OpenSmell/smell-monitor/docs/figures/data_flow.png

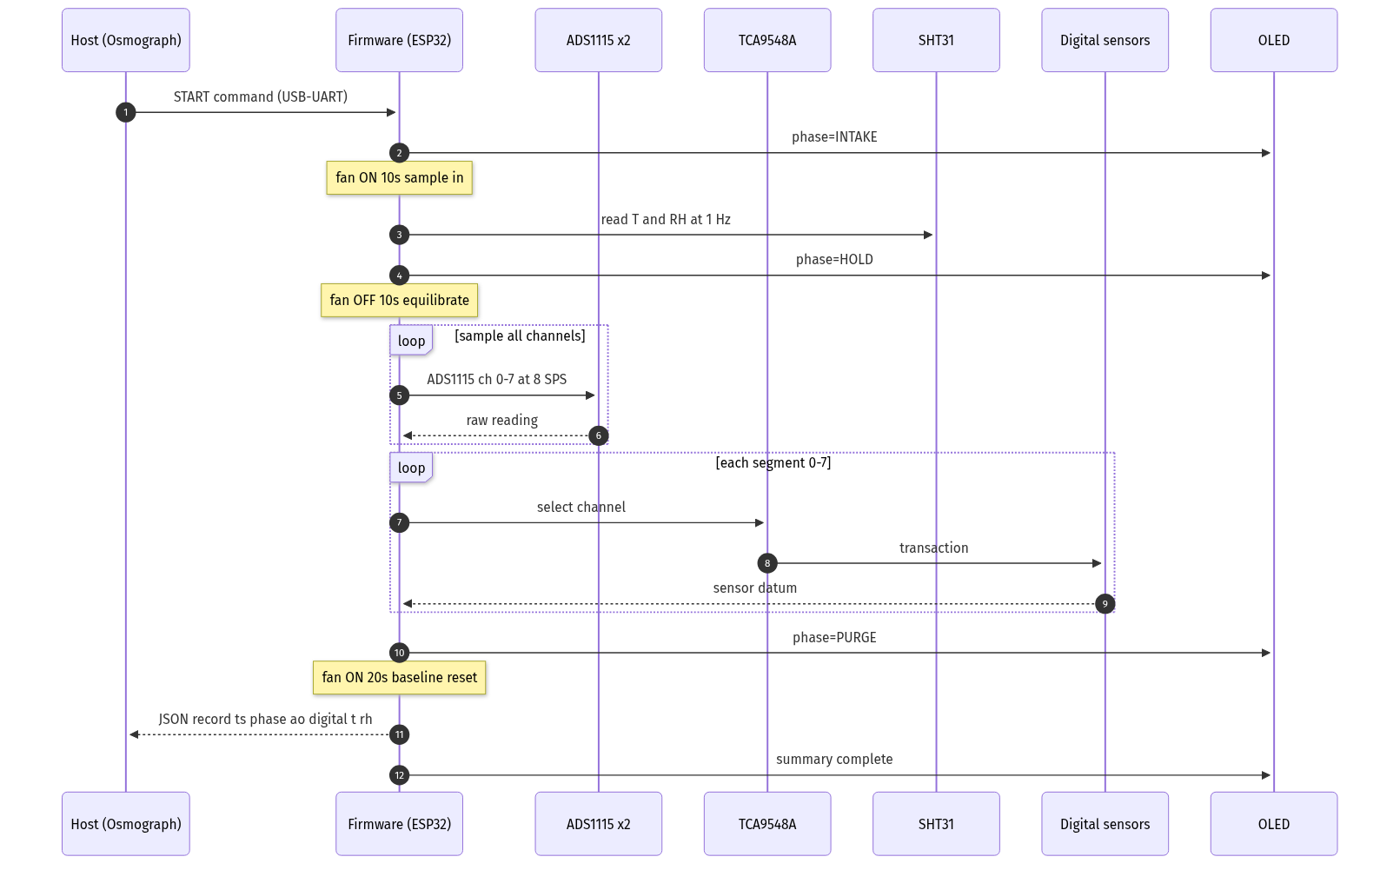
docs/figures/data_flow.png
