OpenSmell/smell-monitor/docs/figures/electrical_block.png

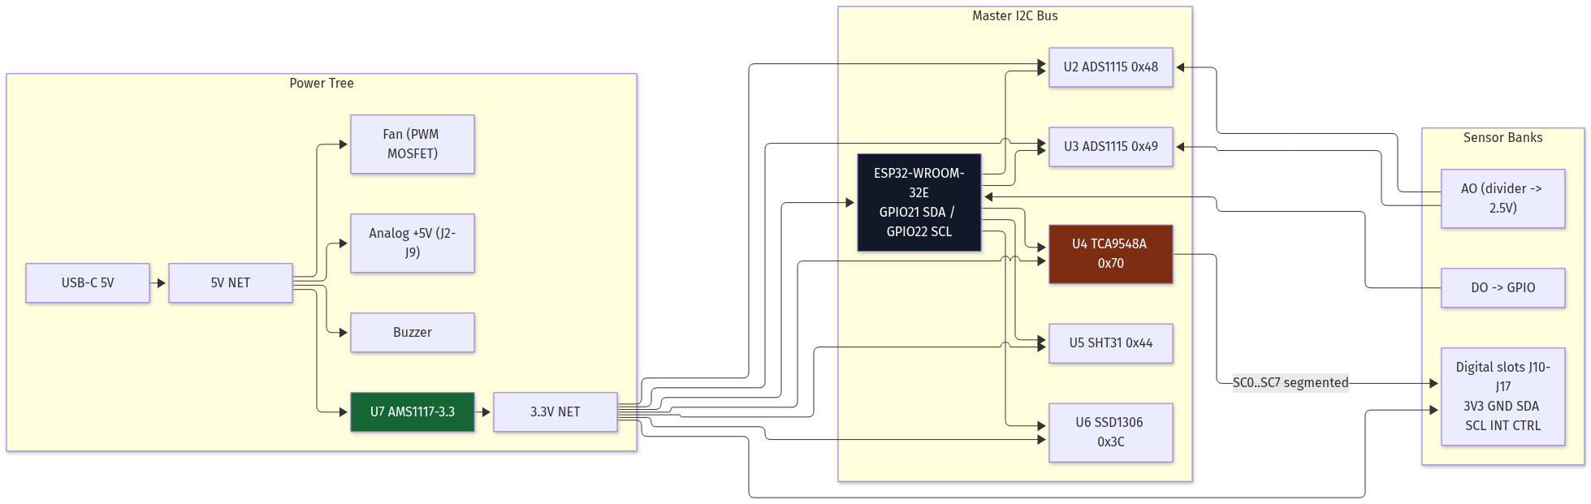
docs/figures/electrical_block.png
