OpenSmell/smell-monitor/docs/figures/mechanical_layout.png

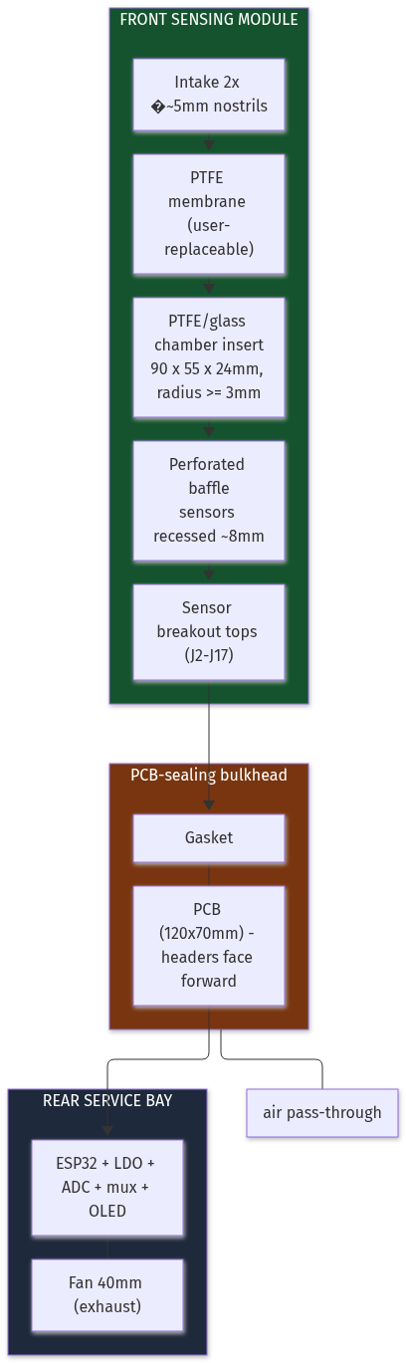
docs/figures/mechanical_layout.png
