OpenSmell/smell-monitor/docs/figures/sensor_slot_map.png

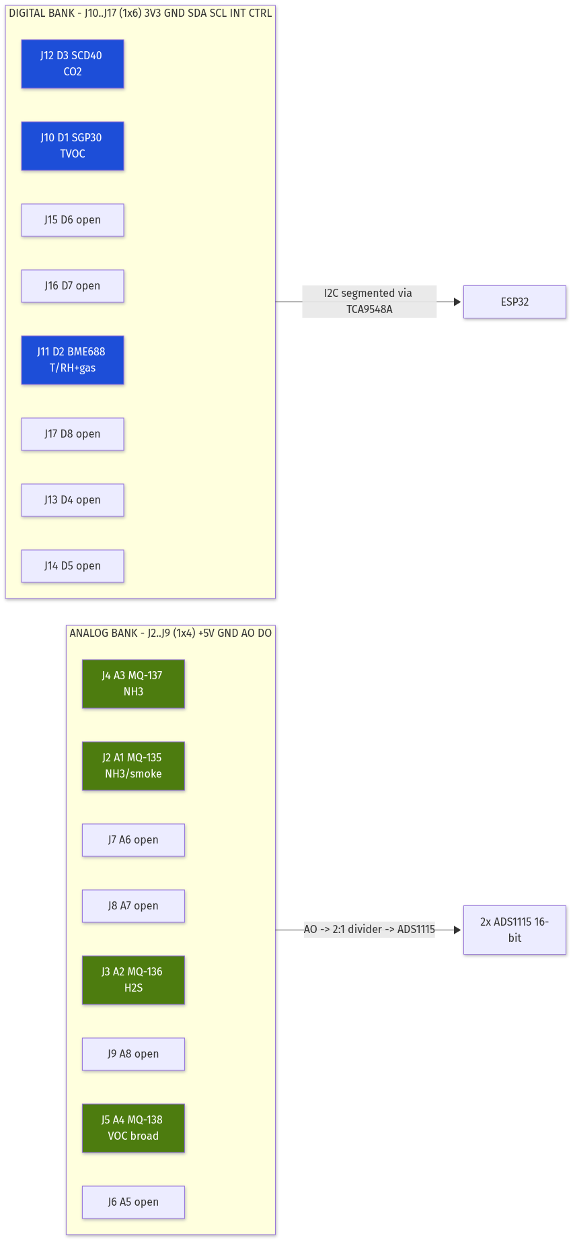
docs/figures/sensor_slot_map.png
