OpenSmell/smell-monitor/electrical/bom.csv

Designator | Value | Footprint | Quantity
BZ1 | MBT-12A05 | Buzzer_Beeper:Buzzer_12x9.5RM7.6 | 1
C1-C9 | 100nF | Capacitor_SMD:C_0603_1608Metric | 9
C10-C12 | 10uF | Capacitor_SMD:C_0603_1608Metric | 3
J1 | USB_C_16P | Connector_USB:USB_C_Receptacle_GCT_USB4105-xx-A_16P_TopMnt_Horizontal | 1
J2-J5 | 1x05 female | Connector_PinSocket_2.54mm:PinSocket_1x05_P2.54mm_Vertical | 4
J6-J9 | 1x06 female | Connector_PinSocket_2.54mm:PinSocket_1x06_P2.54mm_Vertical | 4
J10 | JST-PH 2P fan | Connector_JST:JST_PH_B2B-PH-K_1x02_P2.00mm_Vertical | 1
LED1 | Red | LED_SMD:LED_0603_1608Metric | 1
Q1 | AO3400A | Package_TO_SOT_SMD:SOT-23 | 1
Q2 | MMBT3904 | Package_TO_SOT_SMD:SOT-23 | 1
R1,R2 | 5.1k | Resistor_SMD:R_0603_1608Metric | 2
R3-R13,R17-R20 | 10k | Resistor_SMD:R_0603_1608Metric | 15
R14 | 330 | Resistor_SMD:R_0603_1608Metric | 1
R15,R16,R21-R28 | 4.7k | Resistor_SMD:R_0603_1608Metric | 10
SW1 | MEASURE | Button_Switch_SMD:SW_SPST_TL3342 | 1
SW2 | BOOT | Button_Switch_SMD:SW_SPST_TL3342 | 1
SW3 | RESET | Button_Switch_SMD:SW_SPST_TL3342 | 1
U1 | ESP32-WROOM-32E | RF_Module:ESP32-WROOM-32E | 1
U2 | ADS1115 | Package_SO:MSOP-10_3x3mm_P0.5mm | 1
U3 | CH340C | Package_SO:SOIC-16_3.9x9.9mm_P1.27mm | 1
U4 | TCA9548A | Package_SO:TSSOP-24_4.4x7.8mm_P0.65mm | 1
U5 | SHT31-DIS-B | Sensor_Humidity:Sensirion_DFN-8-1EP_2.5x2.5mm_P0.5mm_EP1.1x1.7mm | 1
U6 | SSD1306-B | Connector_PinHeader_2.54mm:PinHeader_1x04_P2.54mm_Vertical | 1
U7 | AMS1117-3.3 | Package_TO_SOT_SMD:SOT-223-3_TabPin2 | 1
