OpenSmell/smell-monitor/electrical/smell_monitor_v1_1/fab/smell_monitor_v1_1.step

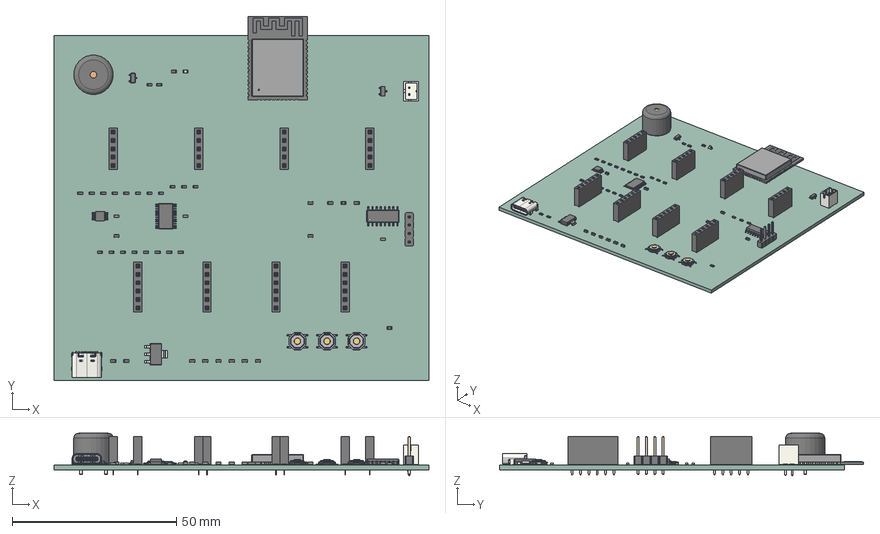
[picture p5: CAD file, 2026-10-21]
electrical/smell_monitor_v1_1/fab/smell_monitor_v1_1.step
114.0 x 110.8 x 12.9 mm
R_0603_1608Metric x 28
C_0603_1608Metric x 12
PinSocket_1x05_P2.54mm_Vertical x 4
TSSOP-24_4.4x7.8mm_P0.65mm
PinSocket_1x06_P2.54mm_Vertical x 4
SOT-23 x 2
SW_SPST_TL3342 x 3
PinHeader_1x04_P254mm_Vertical
Buzzer_12x95RM76
LED_0603_1608Metric
SOT-223
JST_B2B_PH_K
USB_C_Receptacle_16P_TopMnt_Horizontal_GCT_USB4105-xx-A
SOIC-16_3.9x9.9mm_P1.27mm
ESP32-WROOM-32E
MSOP-10_3x3mm_P0.5mm
smell_monitor_v1_1_PCB
