OpenSmell/smell-monitor/mechanical/drawings/sheets/OS-002.dxf

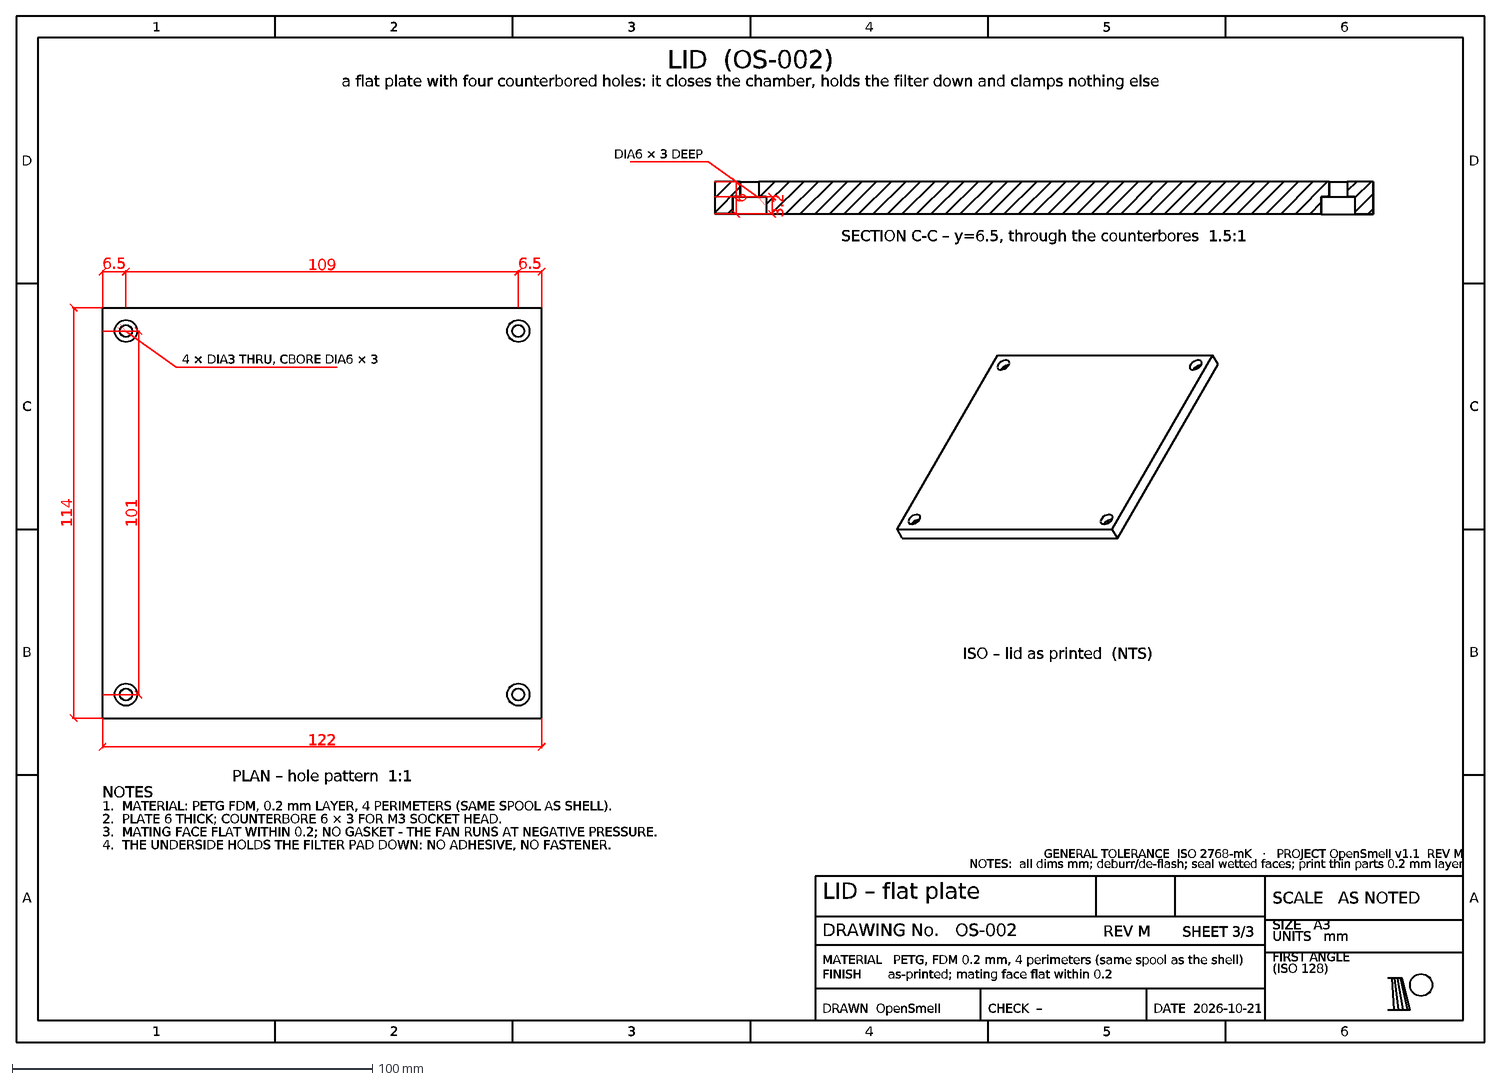
[picture p6: CAD file, 2026-10-21]
mechanical/drawings/sheets/OS-002.dxf
1
2
3
4
5
6
A
B
C
D
LID (OS-002)
a flat plate with four counterbored holes: it closes the chamber, holds the filter down and clamps nothing else
PLAN – hole pattern 1:1
122
114
6.5
109
101
4 × DIA3 THRU, CBORE DIA6 × 3
SECTION C-C – y=6.5, through the counterbores 1.5:1
3.2
DIA6 × 3 DEEP
ISO – lid as printed (NTS)
NOTES
1. MATERIAL: PETG FDM, 0.2 mm LAYER, 4 PERIMETERS (SAME SPOOL AS SHELL).
2. PLATE 6 THICK; COUNTERBORE 6 × 3 FOR M3 SOCKET HEAD.
3. MATING FACE FLAT WITHIN 0.2; NO GASKET - THE FAN RUNS AT NEGATIVE PRESSURE.
4. THE UNDERSIDE HOLDS THE FILTER PAD DOWN: NO ADHESIVE, NO FASTENER.
LID – flat plate
DRAWING No. OS-002
REV M
SHEET 3/3
MATERIAL PETG, FDM 0.2 mm, 4 perimeters (same spool as the shell)
FINISH as-printed; mating face flat within 0.2
DRAWN OpenSmell
CHECK –
DATE 2026-10-21
SCALE AS NOTED
SIZE A3
UNITS mm
FIRST ANGLE
(ISO 128)
NOTES: all dims mm; deburr/de-flash; seal wetted faces; print thin parts 0.2 mm layer
GENERAL TOLERANCE ISO 2768-mK · PROJECT OpenSmell v1.1 REV M
