OpenSmell/smell-monitor/mechanical/freecad/smell_monitor.STEP

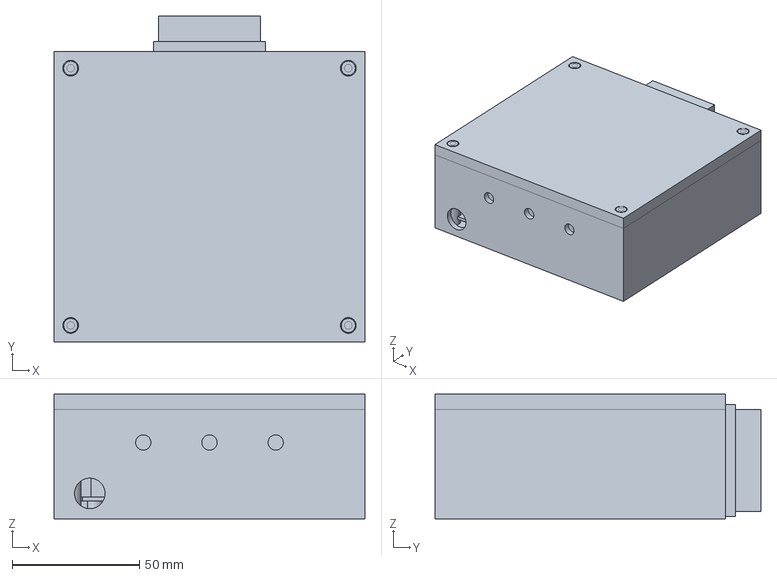
[picture p7: CAD file, 2026-10-21]
mechanical/freecad/smell_monitor.STEP
122.0 x 128.0 x 49.0 mm
