OpenSmell/smell-monitor/mechanical/drawings/sheets/OS-001.dxf

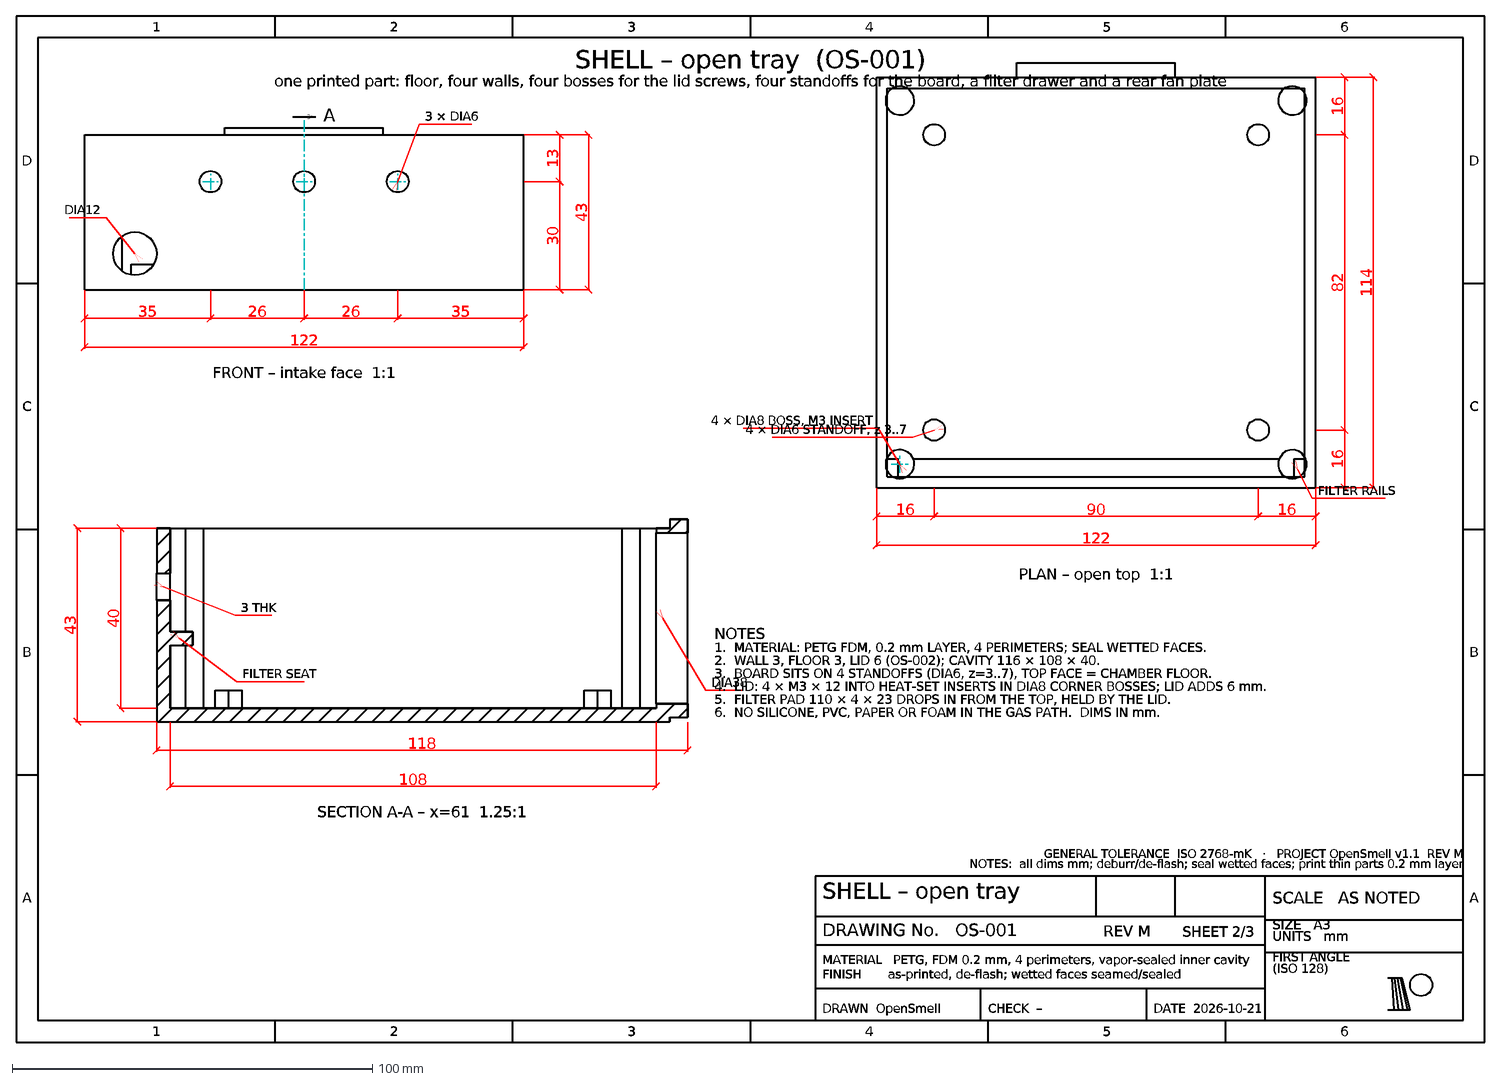
[picture p8: CAD file, 2026-10-21]
mechanical/drawings/sheets/OS-001.dxf
1
2
3
4
5
6
A
B
C
D
SHELL – open tray (OS-001)
one printed part: floor, four walls, four bosses for the lid screws, four standoffs for the board, a filter drawer and a rear fan plate
FRONT – intake face 1:1
35
26
122
30
13
43
3 × DIA6
DIA12
SECTION A-A – x=61 1.25:1
118
108
40
3 THK
FILTER SEAT
DIA38
PLAN – open top 1:1
16
90
82
114
4 × DIA8 BOSS, M3 INSERT
4 × DIA6 STANDOFF, z 3..7
FILTER RAILS
NOTES
1. MATERIAL: PETG FDM, 0.2 mm LAYER, 4 PERIMETERS; SEAL WETTED FACES.
2. WALL 3, FLOOR 3, LID 6 (OS-002); CAVITY 116 × 108 × 40.
3. BOARD SITS ON 4 STANDOFFS (DIA6, z=3..7), TOP FACE = CHAMBER FLOOR.
4. LID: 4 × M3 × 12 INTO HEAT-SET INSERTS IN DIA8 CORNER BOSSES; LID ADDS 6 mm.
5. FILTER PAD 110 × 4 × 23 DROPS IN FROM THE TOP, HELD BY THE LID.
6. NO SILICONE, PVC, PAPER OR FOAM IN THE GAS PATH. DIMS IN mm.
SHELL – open tray
DRAWING No. OS-001
REV M
SHEET 2/3
MATERIAL PETG, FDM 0.2 mm, 4 perimeters, vapor-sealed inner cavity
FINISH as-printed, de-flash; wetted faces seamed/sealed
DRAWN OpenSmell
CHECK –
DATE 2026-10-21
SCALE AS NOTED
SIZE A3
UNITS mm
FIRST ANGLE
(ISO 128)
NOTES: all dims mm; deburr/de-flash; seal wetted faces; print thin parts 0.2 mm layer
GENERAL TOLERANCE ISO 2768-mK · PROJECT OpenSmell v1.1 REV M
