OpenSmell/smell-monitor/mechanical/freecad/smell_monitor_lid.STEP

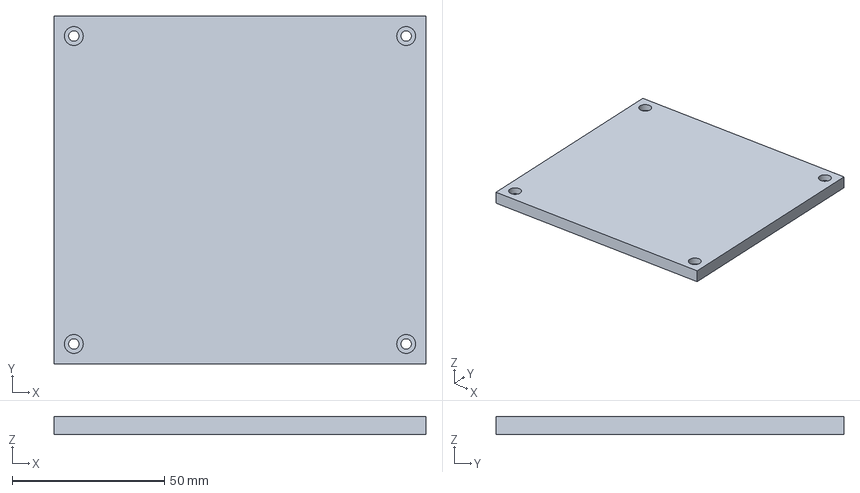
[picture p9: CAD file, 2026-10-21]
mechanical/freecad/smell_monitor_lid.STEP
122.0 x 114.0 x 6.00 mm
