OpenSmell/smell-monitor/mechanical/drawings/sheets/OS-000.dxf

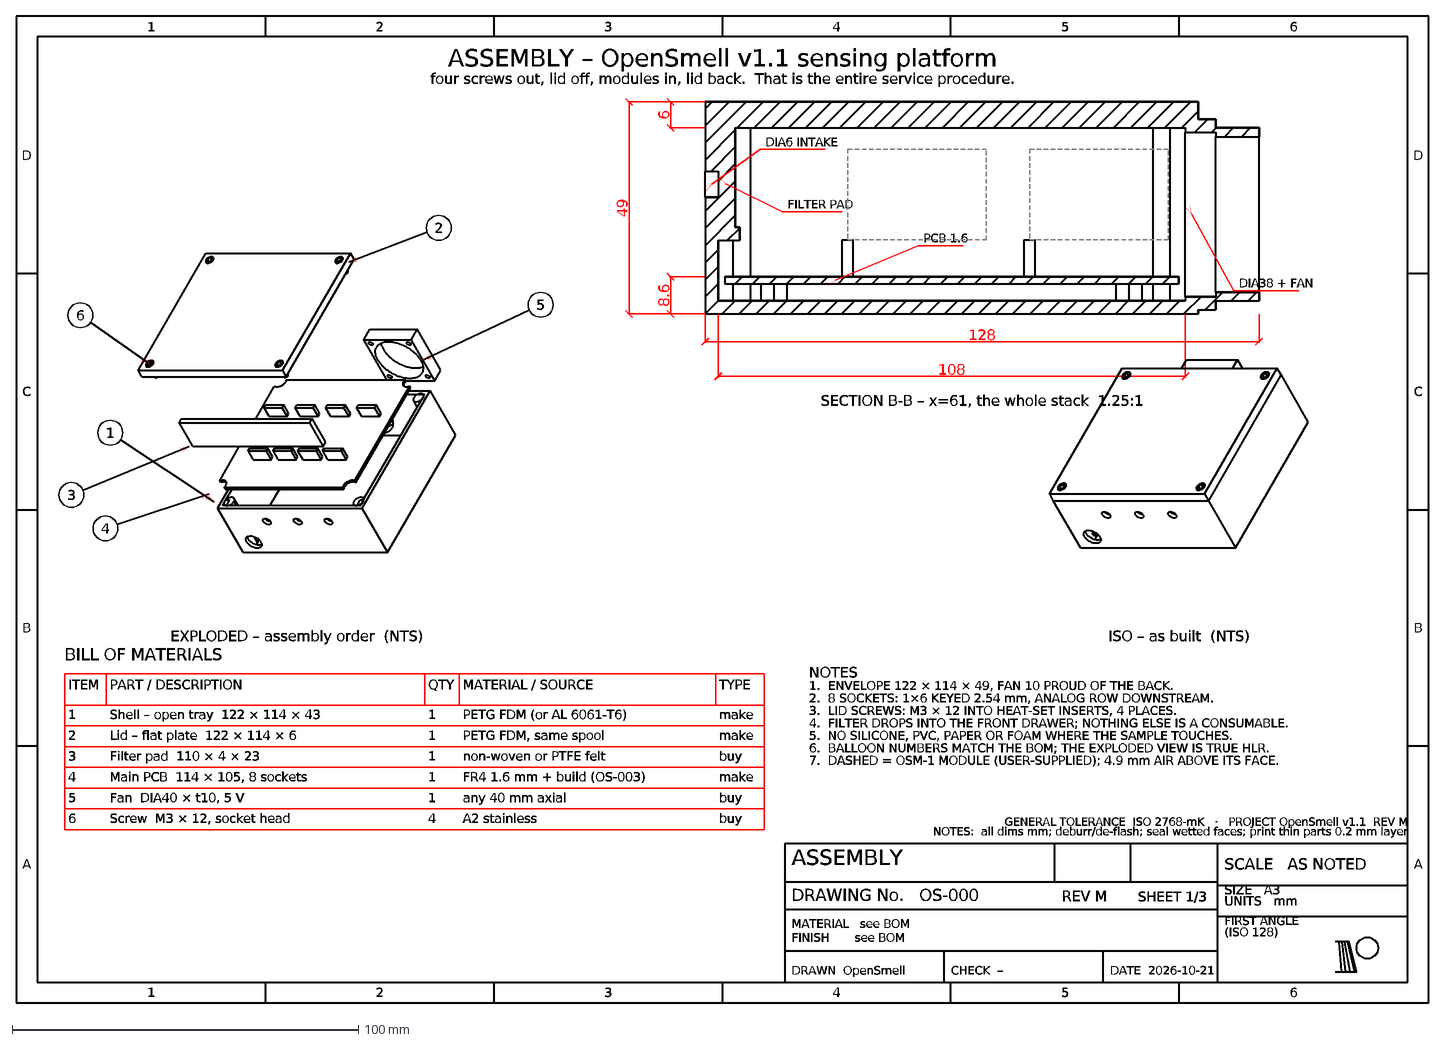
[picture p10: CAD file, 2026-10-21]
mechanical/drawings/sheets/OS-000.dxf
1
2
3
4
5
6
A
B
C
D
ASSEMBLY – OpenSmell v1.1 sensing platform
four screws out, lid off, modules in, lid back. That is the entire service procedure.
EXPLODED – assembly order (NTS)
SECTION B-B – x=61, the whole stack 1.25:1
128
108
8.6
49
DIA6 INTAKE
FILTER PAD
PCB 1.6
DIA38 + FAN
ISO – as built (NTS)
BILL OF MATERIALS
ITEM
PART / DESCRIPTION
QTY
MATERIAL / SOURCE
TYPE
Shell – open tray 122 × 114 × 43
PETG FDM (or AL 6061-T6)
make
Lid – flat plate 122 × 114 × 6
PETG FDM, same spool
Filter pad 110 × 4 × 23
non-woven or PTFE felt
buy
Main PCB 114 × 105, 8 sockets
FR4 1.6 mm + build (OS-003)
Fan DIA40 × t10, 5 V
any 40 mm axial
Screw M3 × 12, socket head
A2 stainless
NOTES
1. ENVELOPE 122 × 114 × 49, FAN 10 PROUD OF THE BACK.
2. 8 SOCKETS: 1×6 KEYED 2.54 mm, ANALOG ROW DOWNSTREAM.
3. LID SCREWS: M3 × 12 INTO HEAT-SET INSERTS, 4 PLACES.
4. FILTER DROPS INTO THE FRONT DRAWER; NOTHING ELSE IS A CONSUMABLE.
5. NO SILICONE, PVC, PAPER OR FOAM WHERE THE SAMPLE TOUCHES.
6. BALLOON NUMBERS MATCH THE BOM; THE EXPLODED VIEW IS TRUE HLR.
7. DASHED = OSM-1 MODULE (USER-SUPPLIED); 4.9 mm AIR ABOVE ITS FACE.
ASSEMBLY
DRAWING No. OS-000
REV M
SHEET 1/3
MATERIAL see BOM
FINISH see BOM
DRAWN OpenSmell
CHECK –
DATE 2026-10-21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
