OpenSmell/smell-monitor/mechanical/freecad/smell_monitor_shell.STEP

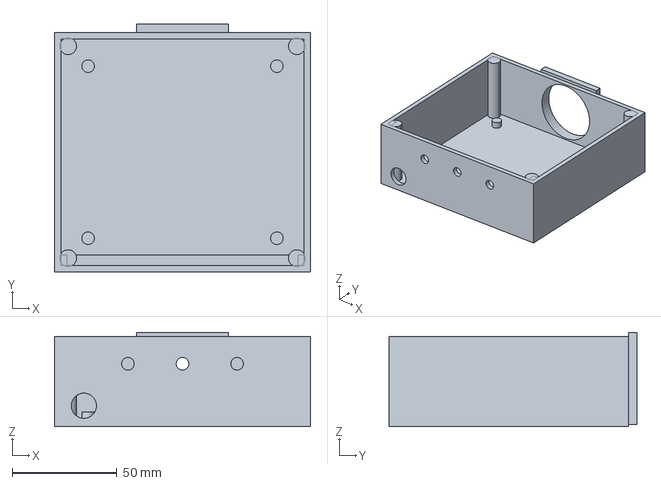
[picture p11: CAD file, 2026-10-21]
mechanical/freecad/smell_monitor_shell.STEP
122.0 x 118.0 x 45.0 mm
