OpenSmell/smell-monitor/mechanical/freecad/smell_monitor_baffle.STEP

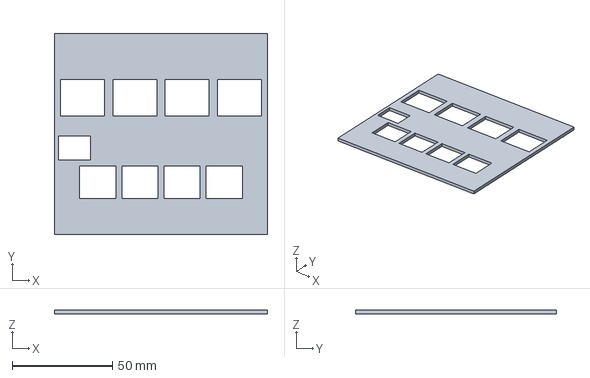
[picture p12: CAD file, 2026-10-20]
mechanical/freecad/smell_monitor_baffle.STEP
106.0 x 100.0 x 2.00 mm
