OpenSmell/smell-monitor/(list of files, cad)

Other CAD files:
mechanical/freecad/smell_monitor_baffle.stl
mechanical/freecad/smell_monitor_lid.stl
mechanical/freecad/smell_monitor_shell.stl
