OpenSmell/smell-monitor/electrical/smell_monitor_v1_1/smell_monitor_v1_1.pdf

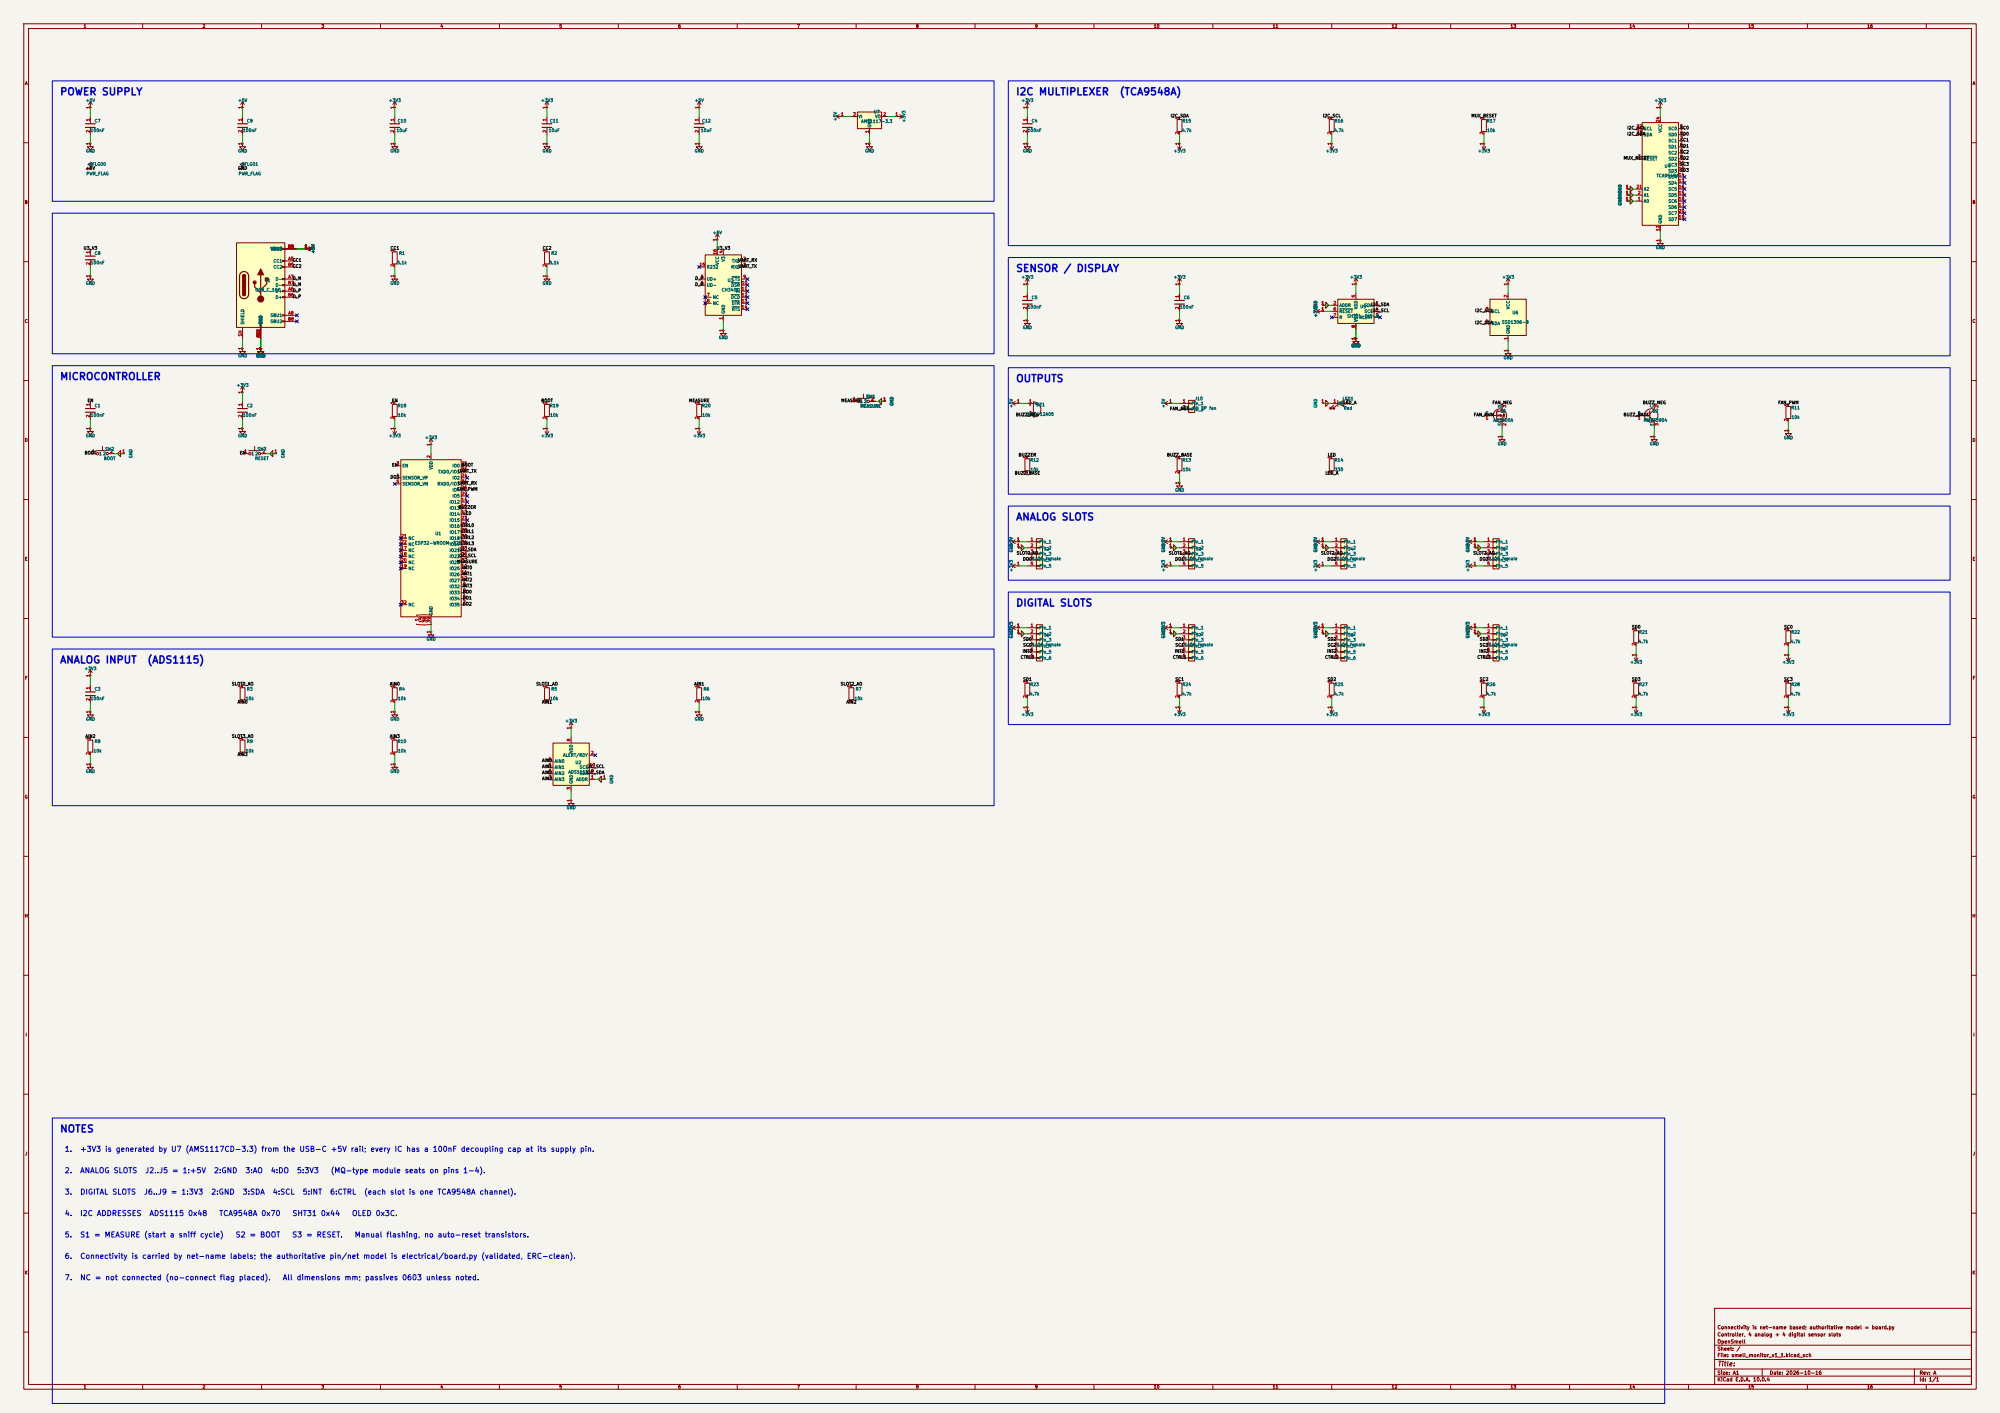
[picture p13: page 1]

4 UD+ 5 UD- 6 NC 7 NC 8 CTS 9 DSR 10 RI 11 DCD 12 DTR 13 RTS 14 R232 15 VCC 16 U3 CH340C

Connectivity is net-name based; authoritative model = board.py GND

1. +3V3 is generated by U7 (AMS1117CD-3.3) from the USB-C +5V rail; every IC has a 100nF decoupling cap at its supply pin.

3. DIGITAL SLOTS J6..J9 = 1:3V3 2:GND 3:SDA 4:SCL 5:INT 6:CTRL (each slot is one TCA9548A channel).

6. Connectivity is carried by net-name labels; the authoritative pin/net model is electrical/board.py (validated, ERC-clean).

Size: A1 | Rev: A
KiCad E.D.A. 10.0.4 | Id: 1/1
