OpenSmell/smell-monitor/mechanical/drawings/sheets/OpenSmell_v1.1_sheets.pdf

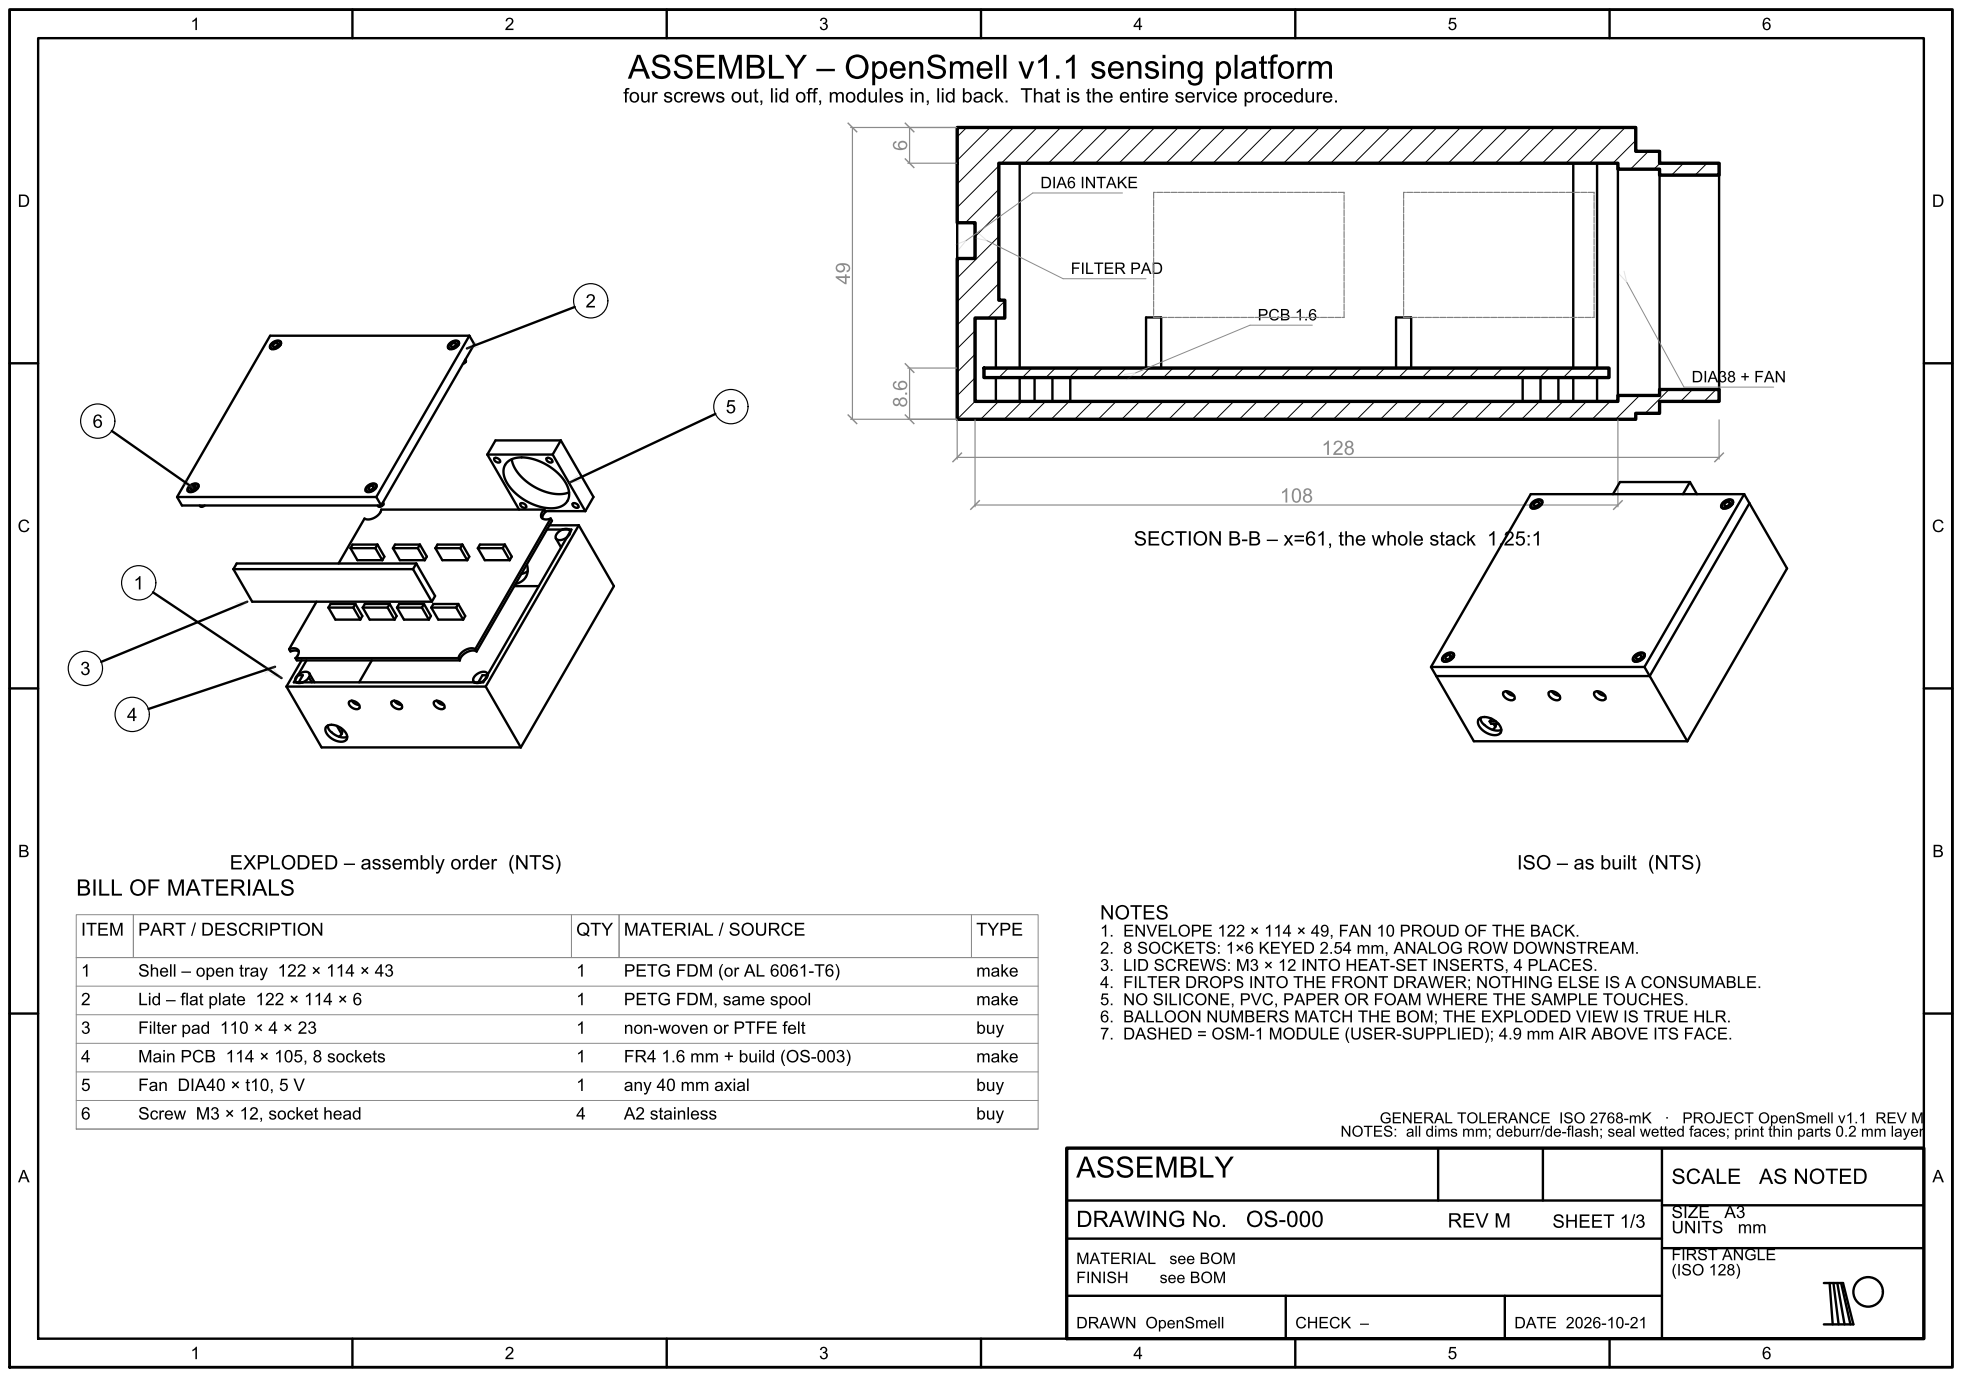
[picture p14: page 1]

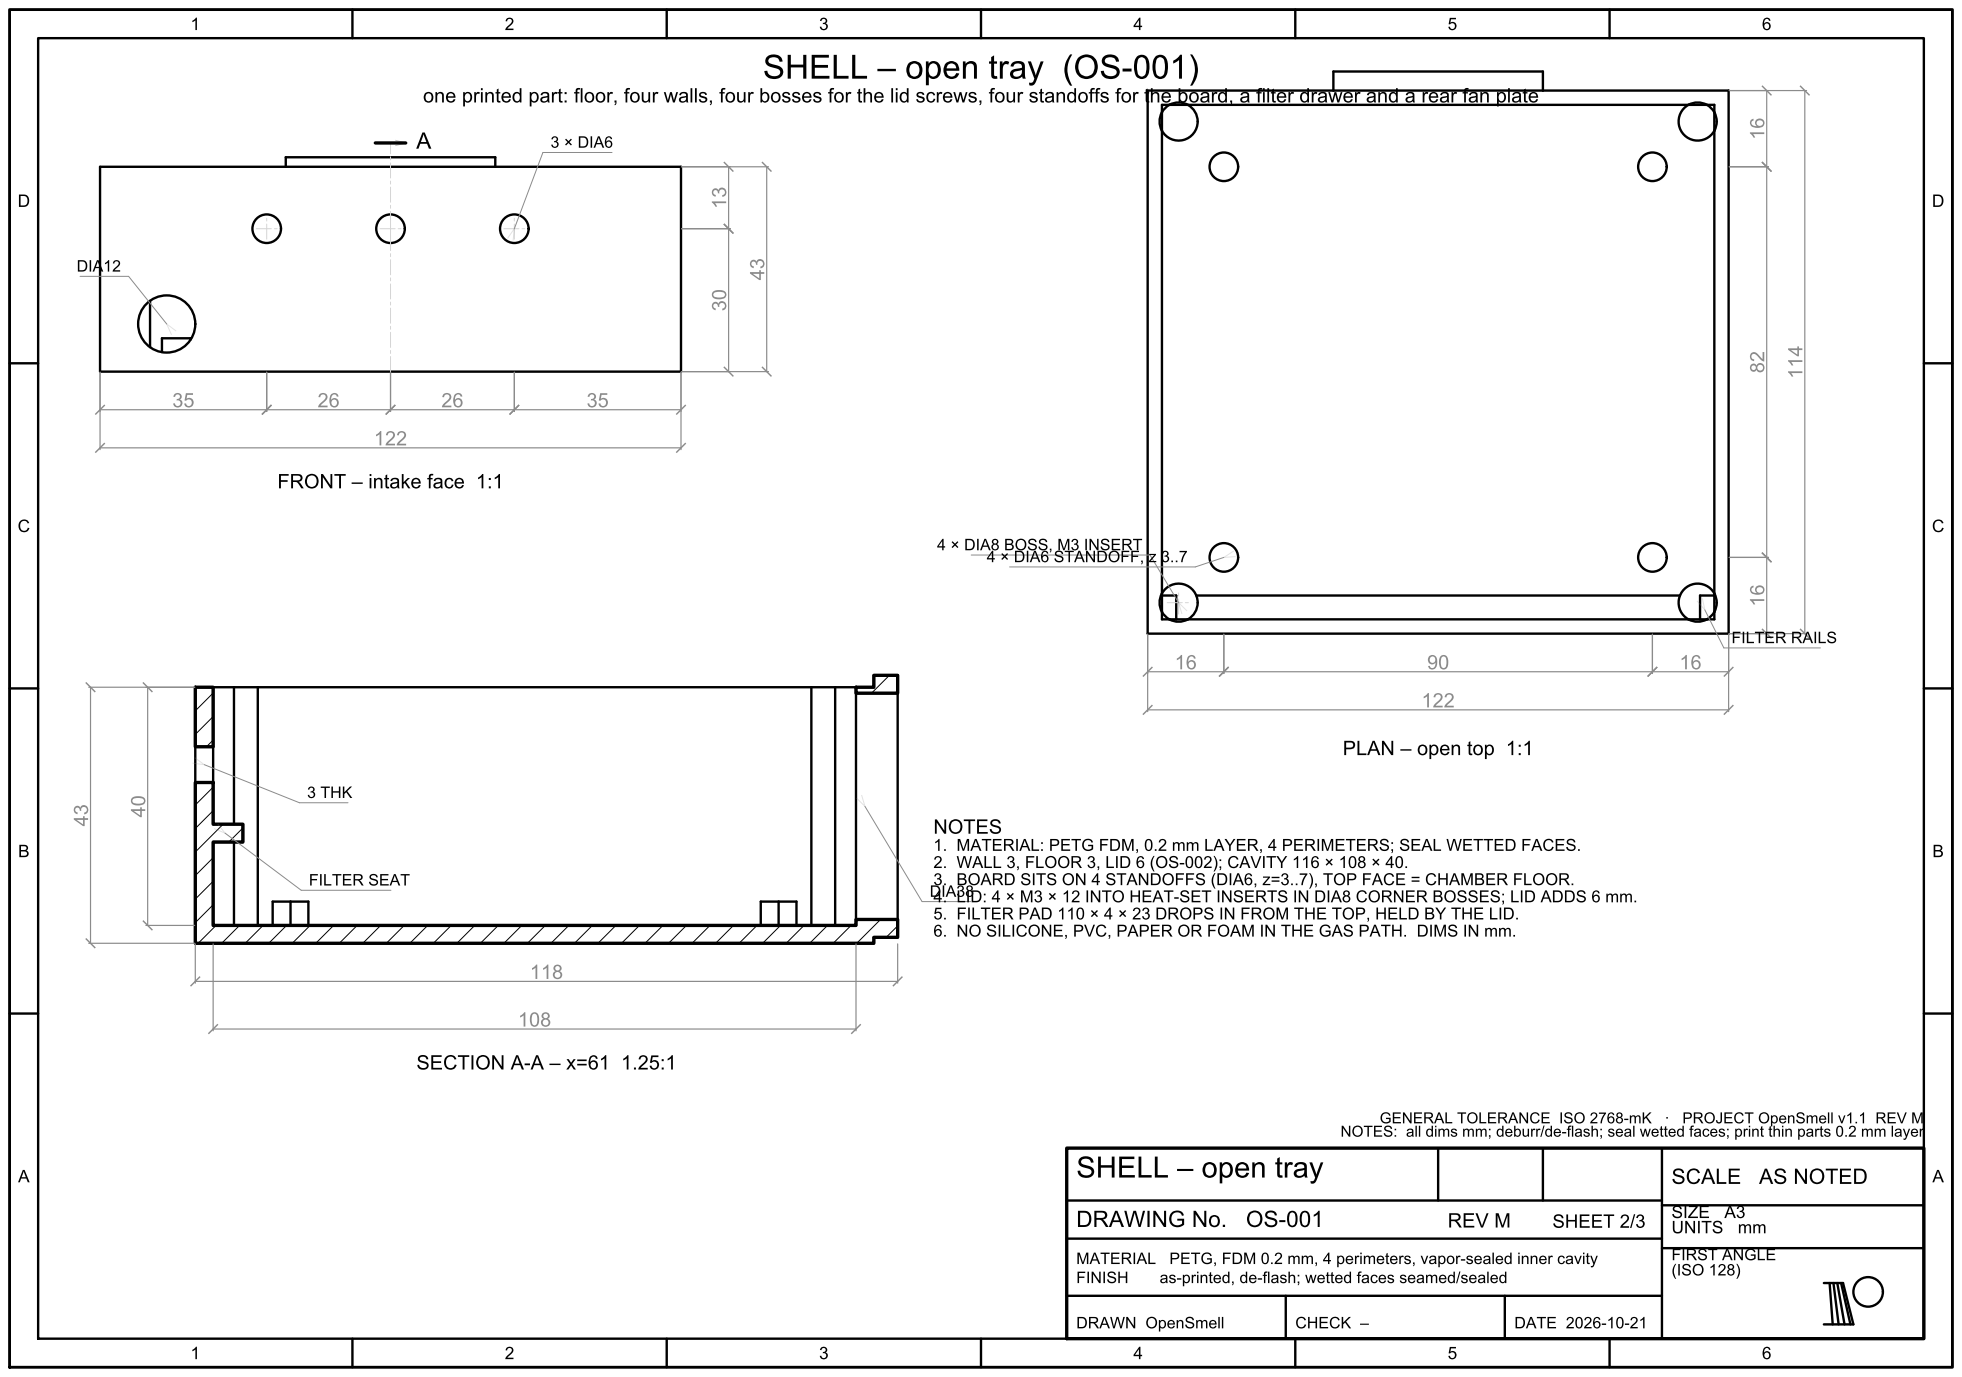
[picture p15: page 2]

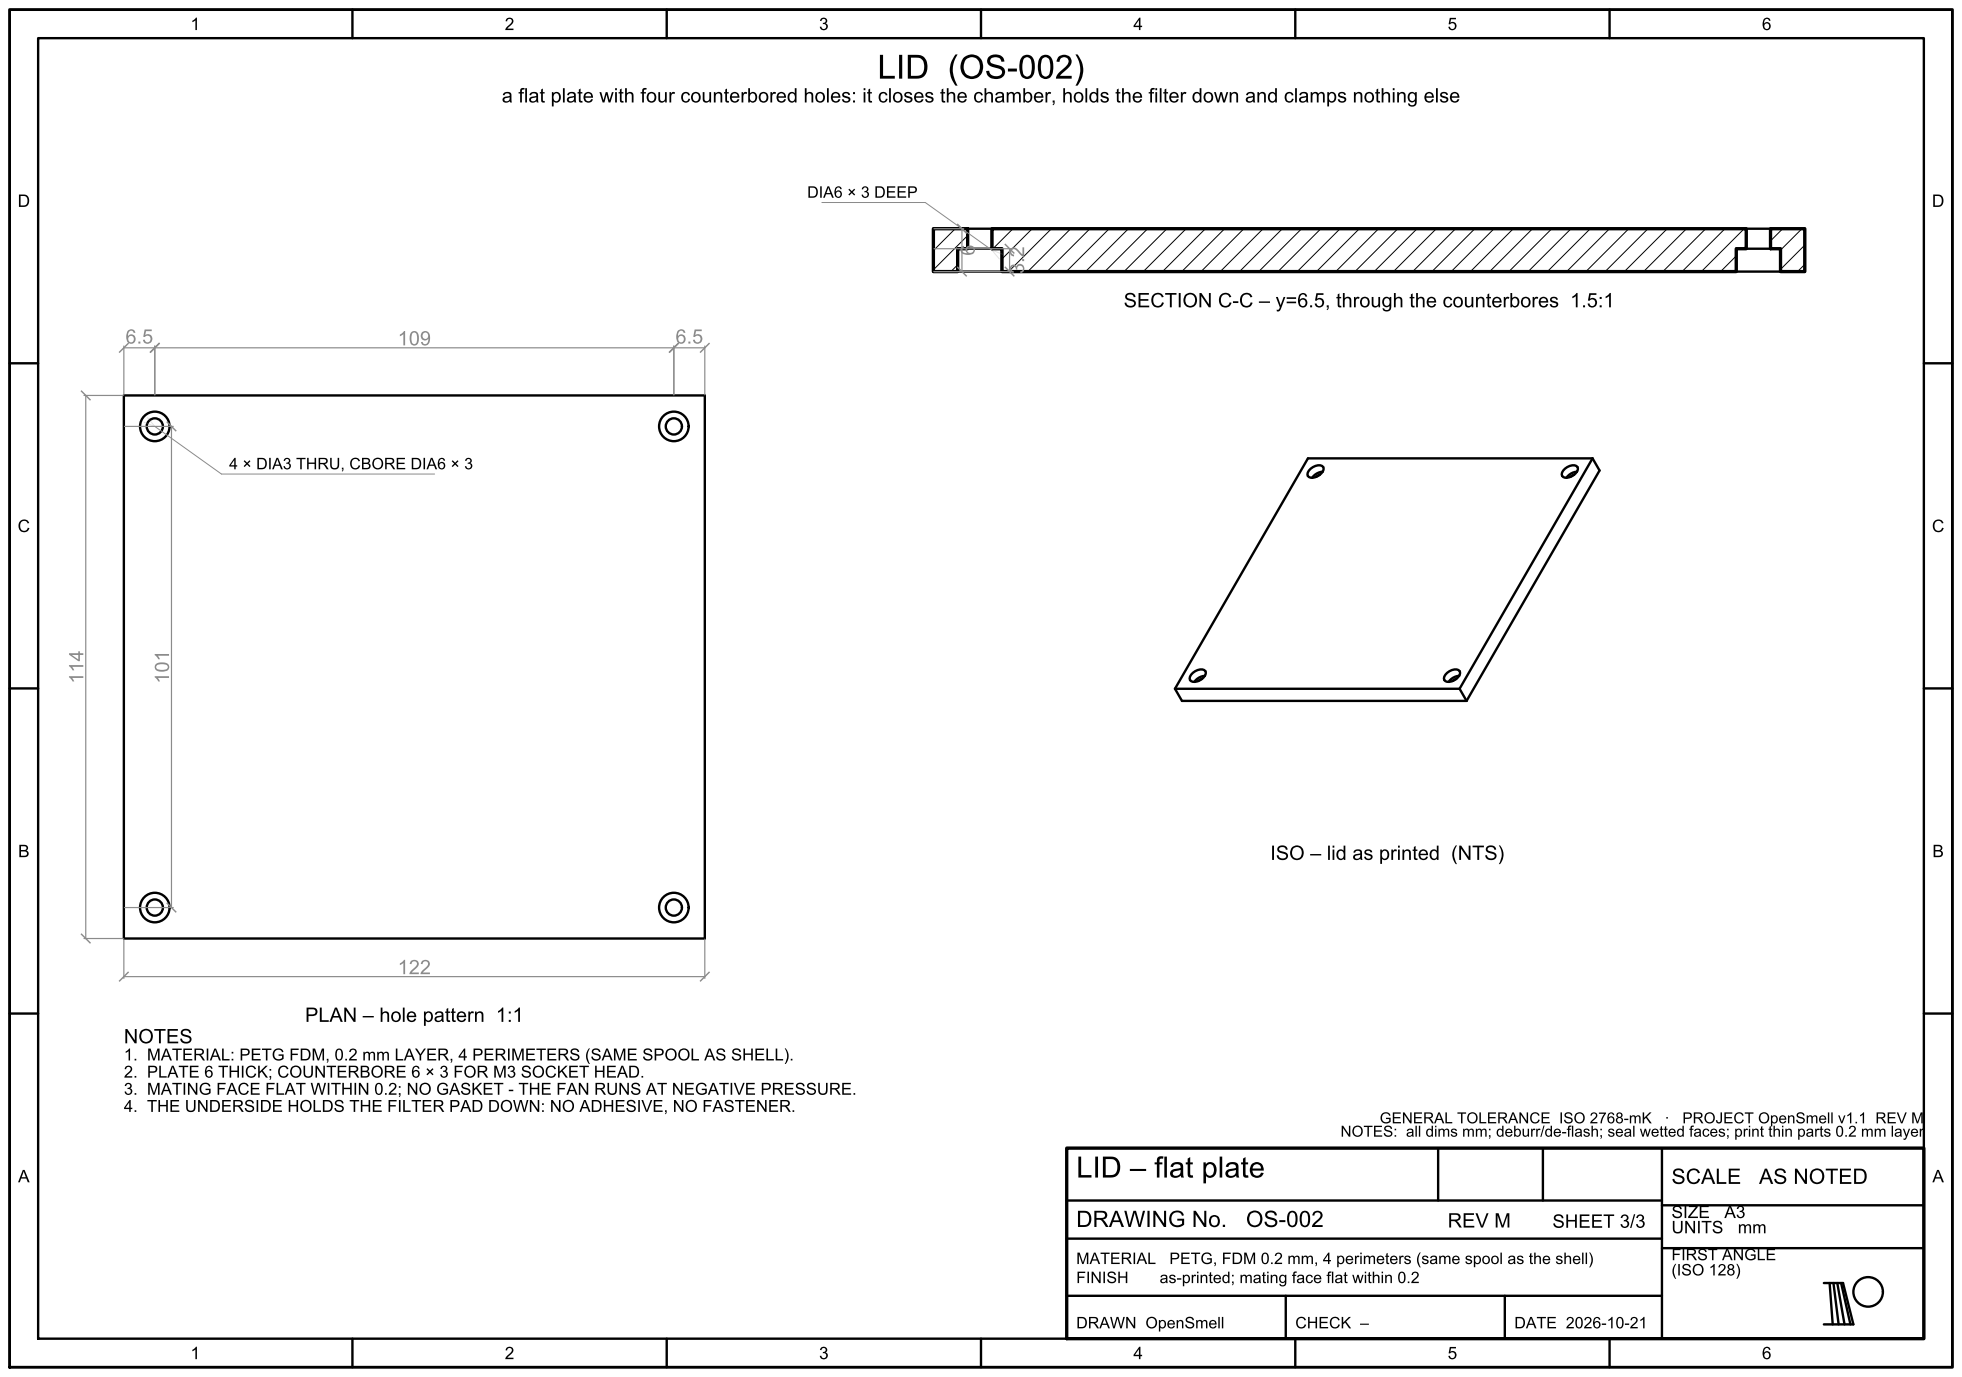
[picture p16: page 3]
