OpenSmell/smell-monitor/(commit log)

2026-09-25 Update README with project details and guidelines
    Added detailed project overview, hardware architecture, sensor interfaces, project status, and contributing guidelines.
2026-10-12 chore: initialize repository with KiCad v0 design and BOM
2026-10-13 docs: lock v1 architecture - spec, manual, assembly guide, diagrams
    - docs/architecture.md: authoritative v1 spec (pneumatic, sensing, electrical, mechanical)
    - docs/manual.md: user-facing printable manual
    - docs/assembly_guide.md: build + fabrication instructions
    - docs/figures/: 5 mermaid diagrams (.mmd + svg + png)
    - README: rewritten to match BOM/architecture; fixes old discrepancies
    - BOM: add U7 AMS1117-3.3 (missing 3.3V rail was a v0 gap)
    - Sub-folder READMEs for electrical/mechanical/firmware
2026-10-16 Add verification scripts for CAD and electrical interfaces
    - Introduced `style_smell_monitor.py` to enhance the visibility of the smell monitor model in FreeCAD.
    - Added `verify_cad.py` for numeric verification of CAD deliverables against the source of truth.
    - Created `verify_electrical.py` to validate the electrical interface and ensure pin budget compliance.
    - Implemented `verify_netlist.py` to check the parity between the KiCad-exported netlist and the board model.
    - Developed `verify_orthogonality.py` to analyze response-diversity and ensure invariants are met.
    - Added `verify_sensor_matrix.py` to validate sensor placement and ensure the recommended pack covers all personas.
2026-10-17 fix(mechanical): seat the PCB as the chamber floor, flip the flow order
    The stacking error: PCB_Z was CAV_Z1 - 1.6 = 58.4 mm, so the board sat in the
    cavity *ceiling* - through the 3 x D6 nostril bores (z 52..58) and the filter
    slab. Air could not enter. PCB_Z is now FLOOR - PCB_T with a matching 1.6 mm
    rebate cut in the shell floor, so the board's top face IS the cavity floor.
    That is the only datum where 4.6's own numbers close: 12 + 37 = 49 = BAFFLE_Z,
    12 + 29 = 41, 49 - 41 = 8 mm recess. PCB_Z is derived from FLOOR/PCB_T, not
    retyped, so the identity cannot drift again.
    - nostril axis 58 -> 55 mm: the full bore now opens into the 11 mm flow lane
    instead of being clipped by the cavity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
2026-10-17 feat(electrical): generate, route and gate the v1.1 PCB
    The routed board in git was not reproducible from anything committed. It is now
    produced by a pipeline in which every stage refuses to do the dangerous thing:
    - gen_pcb.py placement only (outline, footprints, netclasses); refuses to
    overwrite a board that already carries copper without --force.
    The 8 sensing headers land exactly on interface.ANALOG_HEADERS /
    DIGITAL_HEADERS, i.e. exactly on the chamber wells.
    - route_pcb.py DSN -> FreeRouting (java -jar, -mp 12) -> SES; refuses to save
    unless 0 unconnected remain. Runs the router in the throwaway
    DSN/SE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
2026-10-17 feat(firmware): ESP32 v1.1 acquisition with USB / Wi-Fi / BLE telemetry
    Arduino-ESP32 sketch (arduino-cli, esp32:esp32:esp32 partition huge_app):
    4 analog slots via the ADS1115, 4 digital slots through the TCA9548A, SHT31 on
    the master bus, the three-phase cycle (intake / hold / purge), OLED + status LED
    + buzzer, and one JSON record shape sent over USB serial (always on, the wired
    default), Wi-Fi (MQTT + HTTP/WebSocket) or BLE (GATT notify).
    Compiles clean: 1,730,914 bytes (55 % of flash), 20 % RAM. tools/
    verify_firmware_pins.py checks the firmware pin map against interface.PINMAP so
    firmware and hardware contract cannot drift.
2026-10-17 docs: re-sync the blueprint and README with what is now actually built
    Blueprint revision J. The document said things the hardware did not do:
    - 4: redrew the contract diagram as a plan view and stated the flow order
    (digital upstream, analog/MOX downstream) with the reasoning
    - 4.1: analog pin order corrected to 5V GND AO DO 3V3, which is what
    interface.py freezes; the table had 3V3 on pin 2, so a naive 4-pin MQ-type
    module would have landed its GND on 3V3
    - 4.3 / 4.5 / 4.6: U5 now genuinely upstream, plus the reference port, the
    module envelope read in the mounted pose, and a new rule for insertion
    orientation (a 35 mm module cannot be free-oriented in 100 mm of depth)
    - 6.1 / 6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
2026-10-17 mechanical: audit the module envelope against real breakouts, add a fit gate
    The chamber was sized from an assumed 'worst-case analog module 22 x 35 x 23'.
    Checking vendors, that number does not exist: the MQ-135 is sold on 32x20,
    32x22, 36x24 and 40x21 mm boards, the ZE03 is a d23.5 x 24.5 mm can rather than
    a card, the MH-Z19C-PC is 38.8 mm long with a 1.5 mm JST-ZH connector, and
    MICS-6814 / SCD40 / SGP4x / BME688 are SMD parts that are only pluggable on
    somebody's carrier (MICS-6814 also has three analog outputs against one AO per
    slot).
    mechanical/modules.py records what the market actually sells (form, outline,
    connector class, sensing-element geometry) with a source per row, the way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
2026-10-17 tools: measure PCB placement from the board outline, not the sheet origin
    The header and outline checks compared absolute sheet coordinates, so dragging
    the board anywhere in the KiCad sheet (e.g. to centre it) would have failed the
    gate. Both now subtract the board's own Edge.Cuts origin, and the outline size
    is a difference either way.
    Proven by re-running the gate on a copy of the board translated by (+60, +25) mm:
    the placement and outline checks still PASS. (That scratch copy also re-fails
    DRC, but only because moving the copper polygons without re-filling the pours is
    not a valid board.)
    Also carries KiCad's own bookkeeping for the root sheet in the project file.
2026-10-17 docs: rewrite the module envelope sections with the real module data
    blueprint 4.5 no longer quotes a datasheet table that does not exist. It states
    the five facts the audit found (same sensor on different boards, same board with
    different pin orders, SMD-only parts, MICS-6814's three outputs, JST/different
    connector classes), the slot standard that follows from them, and the two
    numbers still to measure. 4.6 corrects the insertion rule that sent a 35 mm
    analog card through the rear wall, fixes the analog pitch derivation to
    1.6 + 23 mm can = 24.6 mm, and records the 26/42/32 mm free depths. 4.8 and 14
    open items rewritten: the module measurement is the top mechanical item, the
    unprotected D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
2026-10-18 mechanical: fill the module database with published vendor numbers
    Looked up the parts instead of asking for calipers. New, cited rows:
    * Sensirion SEK-SCD41 development board: 28 x 24 x 8 mm (technical
    description). Standing on its 24 mm edge it leaves 0.5 mm of the sensor
    recess; flat, its 24 mm width is wider than the 21 mm digital pitch accepts.
    * Adafruit SCD-40 / STEMMA QT class: 25.4 x 17.8 x 4.6 mm, 0.1 in holes plus
    JST-SH. Still fits, including flat-mounted (17.8 mm across).
    * Winsen MH-Z19C: 38.8 x 19.7 x 8.6 mm on a 1.5 mm JST-ZH.
    * Figaro TGS2600: a bare 4-lead TO-5 can (Arrow/SnapEDA) - needs a load
    resistor and heater drive on a carrier, it is not a pl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
2026-10-18 standard: define the OSM-1 module socket (one slot design, repeated)
    The slot is the part that has to outlive the sensors, so it is now defined as a
    published standard and checked by a gate instead of living in prose.
    docs/module-standard.md (OpenSmell Module Standard v1, OSM-1) and
    mechanical/standard.py (the same rules as data, which the gates read) define one
    slot, repeated eight times:
    - a keyed 2.54 mm 1x6 gas-cell socket, +5V GND AO DO 3V3 ID, where ID is a
    1-Wire EEPROM carrying the pinout, the calibration blob and the exposure
    history (TEDS in 1 kbit and one wire);
    - a 3.3 V Qwiic/STEMMA QT port (JST-SH 1.0 mm) at the same slot, adopted rather
    than invented because it is the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
2026-10-18 drawings: dimension the parts, and add an exploded assembly view
    The sheet generator used to place hand-computed paper coordinates and carried a
    handful of overall dimensions, so the sheets showed geometry without stating it.
    The geometry is now dimensioned where it is drawn, and the assembly is shown
    separated.
    - mechanical/freecad/build_smell_monitor.py measures, per view, the (u, v)
    components of the global +X/+Y/+Z axes *in that projection* - the same
    projector aimed at a 100 mm reference line along each axis - and stores them
    in the HLR record as `axes`. An orthographic projection is linear, so this
    inverts it exactly: the sheet generator can put a dimension, a leader or a
    ba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
2026-10-18 cad: ship the 3D part data and the CAD gate's input
    model_hlr.json (the measured hidden-line-removal record the sheet generator and
    the gate read), the assembly STEP and the per-part STEP/STL files were
    gitignored, so a fresh clone could not run tools/verify_cad.py at all - it needs
    the HLR record - and could not get any 3D geometry, only the 2D sheets.
    They are small (~450 KB together) and self-policing: the gate already checks the
    HLR, the meshes and the sheets against mechanical/constants.py, so if the model
    is rebuilt and the committed data is stale, the gate fails rather than shipping a
    drawing that disagrees with the model.
    The .FCStd editing document and the PNG plots stay ignored (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
2026-10-20 Drawings: real sections (hatched cut faces), no hidden-line plans, 1:1 baffle template, isometric orientation
2026-10-20 Docs: record the sealed-shell blocker, the board/enclosure orientation mismatch, and the pH/battery/UI/coating decisions; README gets the plain-language flow and a cost table
2026-10-20 Drawings: legible plate thickness dim, isometric shell view, exploded view clear of the BOM
2026-10-21 mechanical: replace the sealed shell with an open tray and a screwed lid
    The shell as modelled was a solid block with 30 mm of material over the
    chamber: not printable, not assemblable, not serviceable, and the source of
    every empty-box drawing.
    Architecture (constants.py is still the only source):
    - open tray 122 x 114 x 43, 3 mm walls/floor, flat 6 mm lid on 4 x M3
    - board 114 x 105 on four d6 standoffs, top face = chamber floor at z 8.6
    - eight 1x6 sockets, cartridges plug in flat; no baffle, plenum, lane,
    well, window or PTFE insert
    - filter pad 110 x 4 x 23 drops into a front drawer, held by the lid
    - d40 fan outside a 4 mm rear plate through a d38 bore, blind screws
    -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
2026-10-21 cfd: runnable OpenFOAM case for the tray chamber
    One case answers the three questions the hand calculation cannot:
    - exchange time over each row (t63 from a unit-step tracer)
    - row-to-row cascade (upstream vs downstream arrival)
    - whether a filled slot disturbs its neighbours (--omit)
    cfd/gen_geometry.py writes the sockets, cartridges and bosses as an STL from
    constants.py and standard.py, so the mesh cannot drift from the enclosure.
    system/*.dict mesh the cavity (blockMesh -> topoSet -> createPatch ->
    snappyHexMesh), simpleFoam runs k-omega SST with the filter pad as a Darcy
    sink, then scalarTransportFoam runs a unit step on the frozen field and
    report.py prints t63/t90 per probe wi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
2026-10-21 drawings: show the OSM-1 module envelope, fix sheet revision and section label
    The assembly section now draws the module envelope as a phantom: without it
    the 4.9 mm hood over the sensing face - the number the chamber height is
    chosen for - appeared on no drawing. Sheet revision L -> M, date, and the
    lid section label reads y=6.5 (it was printed as 6).
2026-10-21 shell drawing: add the plan view that locates the bosses and standoffs
    The front and the section left the boss and standoff positions to be inferred
    from the lid sheet, which is exactly the gap a maker falls into. OS-001 is now
    front + plan (1:1) + section A-A + notes, all three dimensioned; the shell iso
    moved off the sheet because OS-000 already carries one.
    verify_cad checks the plan extent (fan plate included) and that each of the
    four boss and four standoff centres really projects there.
    Also: README no longer claims 'no sorbent surfaces' (PETG sorbs, just less),
    blueprint stops saying a drawing 'proves' anything or that a cartridge 'never
    shadows' its neighbour, the nostril-height p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
